madhukartemba/vacuum_cleaner_robot/README.md

# vacuum_cleaner_robot

Main video link: https://youtu.be/7Qv4sMdT1jQ
<br>
Docking video link 1: https://youtu.be/siy_URgonHc
<br>
Docking video link 2: https://youtu.be/nBP1SzMJ0e4



This is a 3D printed vacuum cleaner which has all the features that the commercial one has including auto return to home for charging and mapping of the room. The robot's charging dock is also a smart charging dock which guides the robot in alignment with the itself using custom IR codes. It is also internet connected and can be controlled using a mobile app.

It has a powerful BLDC motor and a 3D printed impeller which creates a lot of suction. The air passes through a HEPA filter to remove all the dust particles.





The purified air from the HEPA filter is vented out the back and through the motor and other components cooling them in the process:



The dust box can be removed from the robot for cleaning and HEPA filter replacement:



It also has a rotating cleaning brush below the robot to scrub the dust off the floor!



The wheels of the robot are driven by very precise stepper motors and are also spring loaded which makes them adjust to the surface height variations of the floor and keep the robot on the floor!









It has a big front bumper which has a custom switch making it extremely senstive to bumps. It also has 5 infrared sensors in the front which enable the robot to detect obstacles from a distance and they also help in finding and aligning with the charging base.

p7

p10

The parts were designed in Fusion 360 software and 3D printed using Creality Ender 3.

v22

version2

The hardware components used for version 2 are:

ESP 32

28-BYJ stepper motors

Stepper motor drivers

Connecting wire

Rotating brush

HEPA filter

Geared DC motors

Latching switch

12V DC motor

Five infrared obstacle sensors

Two push buttons

Three 18650 li-ion batteries

Battery management system (3S)

Resistors, transistors and diodes

5V buck converter

PAM8403 amplifier

Two speakers

RGB led

#Internal View:
