madhukartemba/vacuum_cleaner_robot/How the IR communication works.pdf

## Automatic Floor Cleaner Navigation Algorithm

First Review
Date: 7/9/2020(DD/MM/YYYY)

MADHUKAR TEMBA
19BAI1161

## INTRODUCTION

# The aim is to develop an algorithm for a floor cleaning robot which allows it to return to its charging

station.

## OBJECTIVE

# We need to develop a way through which the robot can know the position of the charging station with high

accuracy.

## ABSTRACT

# For that I decided to use IR sensors to figure out

the location.

Some changes are made due to….

- The current robot cleaner does clean well but repeatability of its steps is low. That means the robot cannot precisely execute an action every time.
- The gyroscope sensor being tested suddenly stops responding due to unknown reason. Connected to main controller by I2C bus.
- The robot tends to get stuck at platforms elevated at 2.25cm.

## Changes are:

- Decided to redesign addressing all the issues as I still want to use the current robot.
- Using stepper motors with 2048 steps per revolution this time.
- Making it low profile with spring loaded tires and using a different microcontroller.

## ESP 32

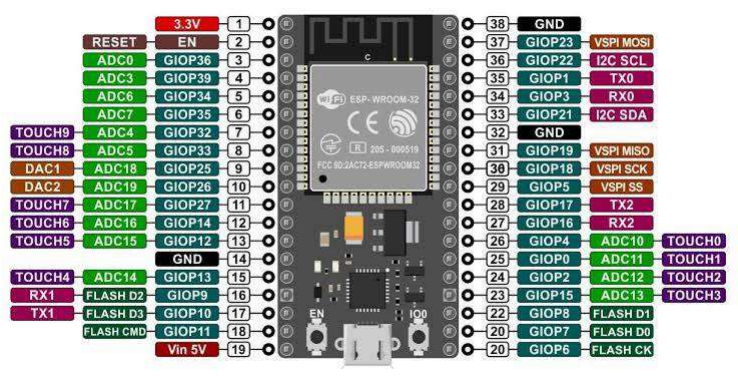
[picture p1: figure]

## BLOCK DIAGRAM

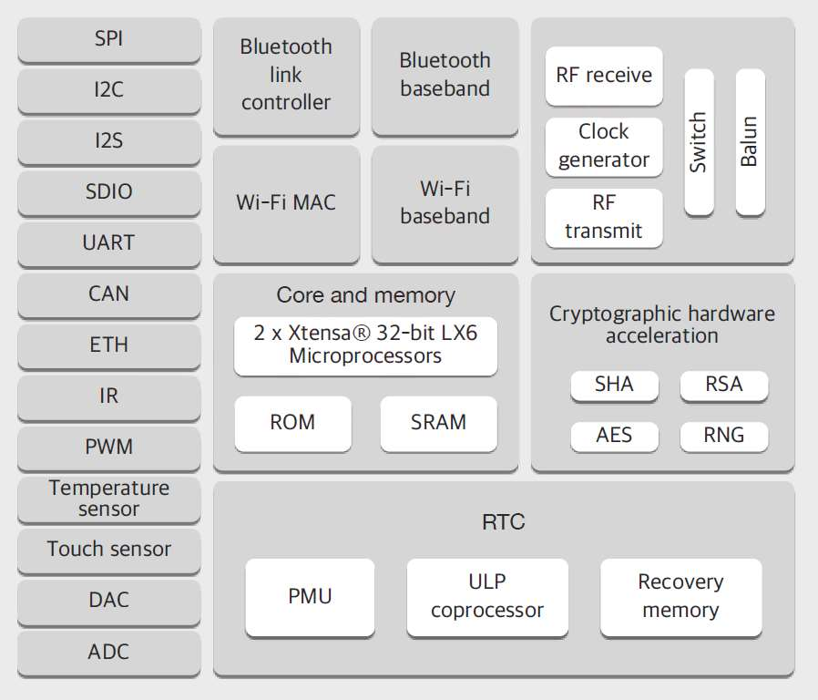
[picture p2: figure]

## EXISTING SYSTEMS

- LIDAR sensors
- Ultrasonic sensors
- 360 degree infrared sensors
- IR proximity sensors.

## LIMITATIONS OF EXISTING SYSTEMS

- LIDAR sensors are expensive and also need a fast processor to process all the data.
- Ultrasonic sensors may not detect an obstacle at a specific angle and are slow as compared to light based sensors. Also modules available in the market have prebuilt ICs which give fixed output making custom implementation hard.
- IR proximity sensors can be affected by sunlight or other devices such as remotes etc.

## PROPOSED SYSTEM

### •I am using IR proximity sensors to detect obstacles but with a custom code allowing them to transmit and

receive data also.

### - There are 5 sensors which will be placed in front of the cleaner and each sensor will be able to receive a

specific code from the charging station.

## WORKING

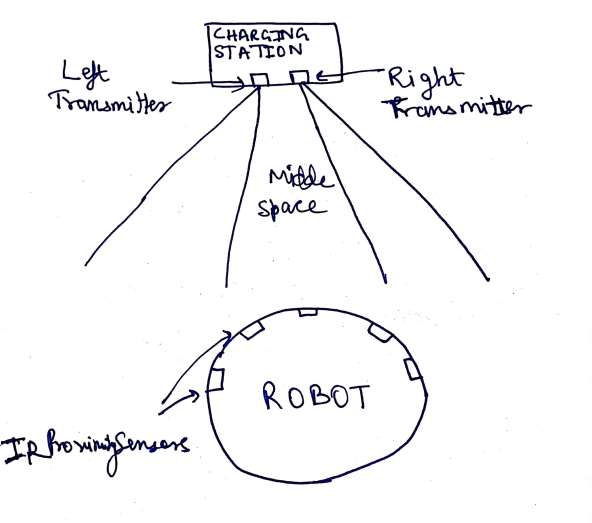
[picture p3: figure]

## WORKING

- When the robot reaches near the base station by backtracking it will turn off its IR LEDs and checks each sensor for the transmitted code.
- If the robot receives the LEFT transmitter’s code only then it will turn right a bit. It will turn left if it receives the right transmitters code.
- If it receives both transmitter’s code or nothing then it will move forward.
- The robot will stop when it detects that it is charging.

## CUSTOM CODE:

- The left and right transmitter will send an 9 bit code. The code will include a header and trailer.

LEFT Transmitter will send: 100100011
RIGHT Transmitter will send: 100010011

The robot when in the centre will receive 100110011 or nothing.

## CODE INCLUDES

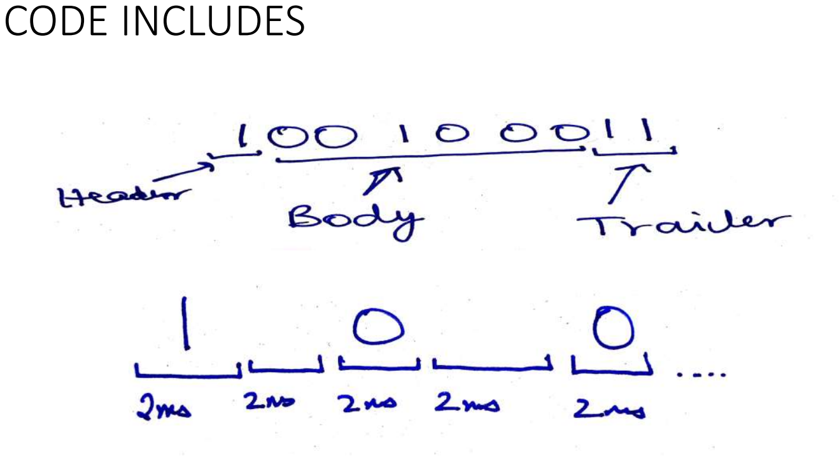
[picture p4: page 15]

## WORKING

# As soon as the robot receives an high signal it starts its timing and stores the 8-

bit code in an array.

# Then it checks if the trailer is correct or

not. If not then it rejects the code.

## ADVANTAGES OF PROPOSED SYSTEM

## The same sensor performs 2 tasks that is

obstacle detection and data receiving.

## The sensors cost less in comparison to other

methods.

## SYSTEM ARCHITECHTURE

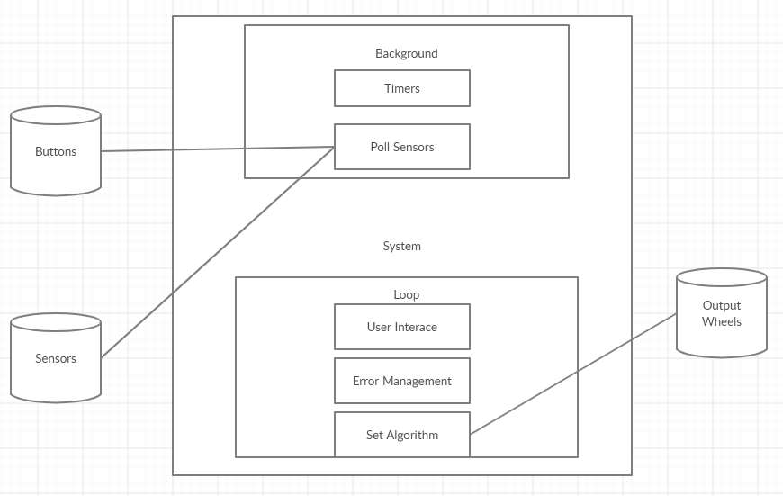
[picture p5: figure]

## USE CASE DIAGRAM

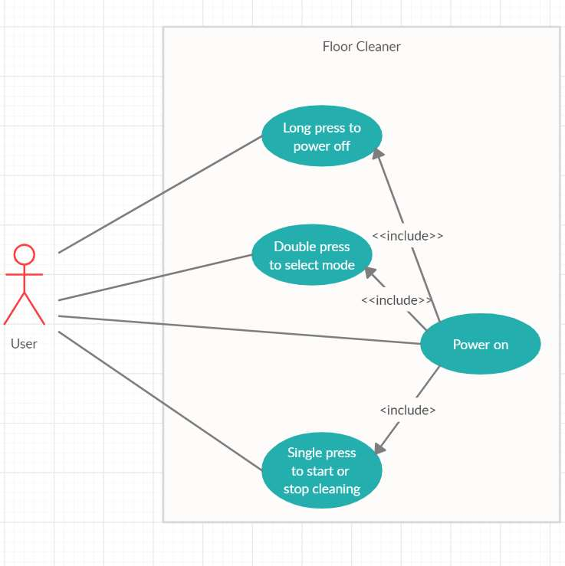
[picture p6: figure]

## DATA FLOW DIAGRAM(ONLY FOR IR SENSOR)

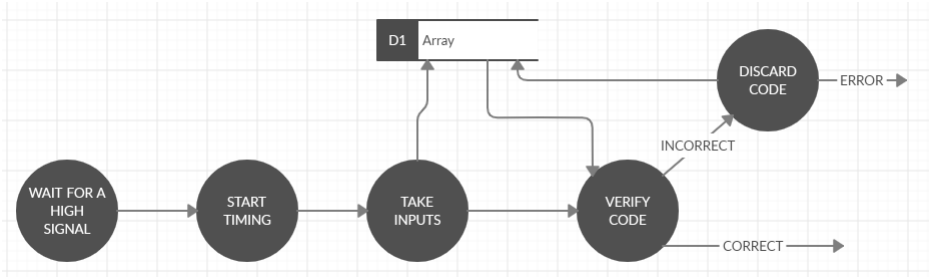
[picture p7: figure]

## IMPLEMENTATION

Video has been removed due to file size limitation. Please go to the link given in review 3 to view all the videos.

## CONCLUSION

# Implemented the IR transmission and receiving function of the

code.

## REFERENCES

- https://www.youtube.com/user/EEVblog
- https://www.youtube.com/channel/UCu7_D0o48KbfhpEohoP7YSQ

Videos:
#171 Arduino Guide to Infrared (IR) Communication also for ESP32 and ESP8266: https://www.youtube.com/watch?v=gADIb1Xw8PE

EEVblog #980 - RoboMaid Automated Vacuum Cleaner Teardown: https://www.youtube.com/watch?v=NJvBQoIb5lg
