madhukartemba/vacuum_cleaner_robot/VacuumCleanerFinal/SoundData.h

/* C:\Users\madhu\Desktop\automode1.wav (26-11-2020 17:16:31)
   StartOffset(h): 00000000, EndOffset(h): 00002D4D, Length(h): 00002D4E */

/* C:\Users\madhu\Desktop\manualmode1.wav (01-12-2020 22:15:10)
   StartOffset(h): 00000000, EndOffset(h): 00003493, Length(h): 00003494 */
/* C:\Users\madhu\Desktop\alarmsound esp32.wav (23-01-2021 21:38:26)
   StartOffset(h): 00000000, EndOffset(h): 00001951, Length(h): 00001952 */

unsigned char doorlockalarmsounddata[6482] = {
  0x52, 0x49, 0x46, 0x46, 0x4A, 0x19, 0x00, 0x00, 0x57, 0x41, 0x56, 0x45,
  0x66, 0x6D, 0x74, 0x20, 0x10, 0x00, 0x00, 0x00, 0x01, 0x00, 0x01, 0x00,
  0x40, 0x1F, 0x00, 0x00, 0x40, 0x1F, 0x00, 0x00, 0x01, 0x00, 0x08, 0x00,
  0x64, 0x61, 0x74, 0x61, 0x62, 0x18, 0x00, 0x00, 0x80, 0x7D, 0x72, 0x72,
  0x81, 0x99, 0xBE, 0x9E, 0x65, 0x45, 0x37, 0x61, 0x9B, 0xD9, 0xB3, 0x73,
  0x56, 0x38, 0x66, 0x9F, 0xCD, 0xAB, 0x6F, 0x52, 0x3F, 0x72, 0x9F, 0xC7,
  0xA0, 0x64, 0x51, 0x4D, 0x79, 0x9C, 0xC5, 0x9A, 0x62, 0x55, 0x54, 0x7C,
  0x9D, 0xC4, 0x96, 0x62, 0x53, 0x53, 0x7D, 0xA1, 0xC5, 0x91, 0x5F, 0x4D,
  0x55, 0x85, 0xA9, 0xC4, 0x85, 0x5A, 0x4D, 0x5E, 0x8D, 0xAF, 0xBA, 0x73,
  0x56, 0x50, 0x70, 0xA0, 0xBC, 0xAE, 0x5E, 0x4A, 0x48, 0x7C, 0xAE, 0xCB,
  0xA2, 0x4F, 0x3F, 0x41, 0x86, 0xBC, 0xD7, 0x95, 0x4B, 0x37, 0x44, 0x97,
  0xCE, 0xD7, 0x7C, 0x40, 0x2C, 0x4D, 0xA8, 0xDC, 0xCE, 0x66, 0x3A, 0x29,
  0x63, 0xBB, 0xE6, 0xB6, 0x53, 0x32, 0x2B, 0x7A, 0xCC, 0xE3, 0x96, 0x4A,
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
  0x8D, 0x75, 0x85, 0x7E, 0x80, 0x7B, 0x83, 0x84, 0x7E, 0x80, 0x7B, 0x7D,
  0x86, 0x7B, 0x89, 0x7B, 0x76, 0x8E, 0x69, 0x98, 0x72, 0x83, 0x86, 0x75,
  0x80, 0x81, 0x80, 0x86, 0x7A, 0x82, 0x7D, 0x77, 0x8B, 0x83, 0x80, 0x70,
  0x87, 0x82, 0x8A, 0x6C, 0x87, 0x84, 0x7B, 0x83, 0x79, 0x85, 0x87, 0x69,
  0x93, 0x79, 0x7D, 0x86, 0x74, 0x93, 0x69, 0x87, 0x85, 0x7F, 0x7D, 0x7F,
  0x7C, 0x8D, 0x6E, 0x88, 0x81, 0x83, 0x79, 0x7B, 0x8D, 0x7A, 0x7B, 0x7F,
  0x8B, 0x79, 0x80, 0x7C, 0x88, 0x74, 0x87, 0x78, 0x90, 0x75, 0x77, 0x8A,
  0x7A, 0x8B, 0x6C, 0x93, 0x79, 0x7B, 0x89, 0x71, 0x94, 0x6B, 0x83, 0x8B,
  0x74, 0x89, 0x79, 0x83, 0x78, 0x83, 0x86, 0x7D, 0x82, 0x82, 0x77, 0x7D,
  0x83, 0x86, 0x85, 0x72, 0x86, 0x7F, 0x79, 0x87, 0x7C, 0x85, 0x7B, 0x81,
  0x7C, 0x88, 0x78, 0x81, 0x82, 0x71, 0x9B, 0x6E, 0x83, 0x7D, 0x7C, 0x8D,
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
};
